lexidays/michess/hardware/antenna-design/coil-drum/coil-drum.FCStd

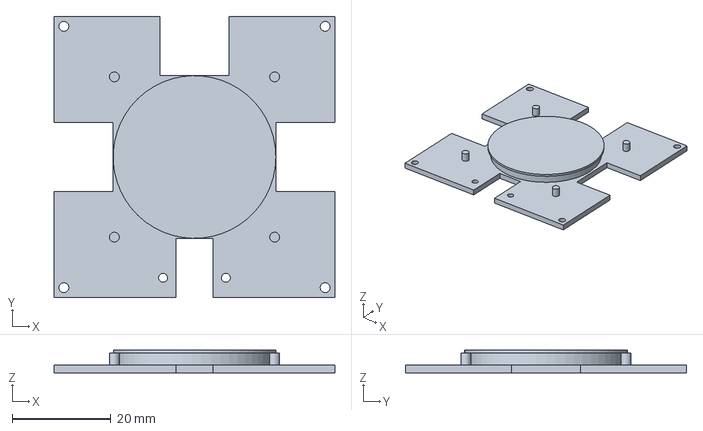
[picture p1: CAD file, 2026-11-11]
hardware/antenna-design/coil-drum/coil-drum.FCStd
57.0 x 57.0 x 4.60 mm
