lexidays/michess/hardware/antenna-design/coil-drum/coil-drum-Body.stl

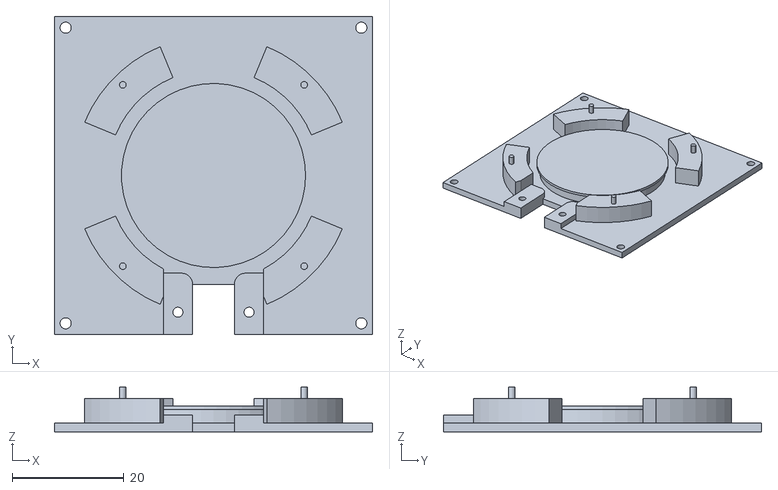
[picture p2: CAD file, 2026-11-04]
hardware/antenna-design/coil-drum/coil-drum-Body.stl
57.0 x 57.0 x 8.00
