lexidays/michess/(list of files, cad)

Other CAD files:
hardware/frame/frame.FCStd
