lexidays/michess/hardware/pcb/coil-connector-board/coil-connector-board.kicad_pcb

## KiCad design hardware/pcb/coil-connector-board/coil-connector-board.kicad_pcb (2026-11-11)

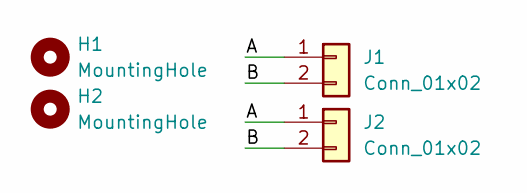
[picture p3: schematic coil-connector-board.kicad_sch]

Parts:
H1, H2: MountingHole; MountingHole_3.2mm_M3
J1: Conn_01x02; PinHeader_1x02_P2.54mm_Vertical
J2: Conn_01x02; JST_PH_S2B-PH-K_1x02_P2.00mm_Horizontal

Connections:
/A: J1.1, J2.1
/B: J1.2, J2.2

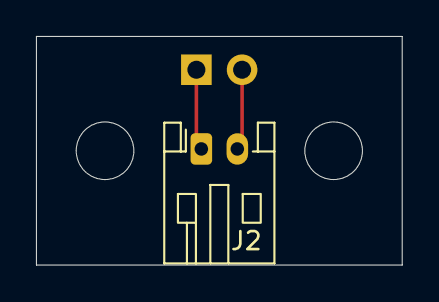
[picture p4: board coil-connector-board.kicad_pcb from above]

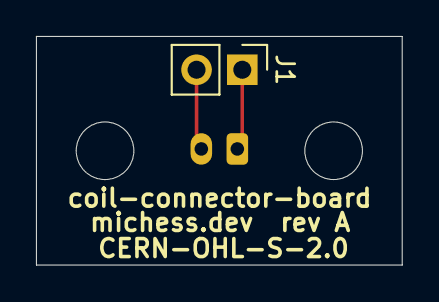
[picture p5: board coil-connector-board.kicad_pcb from below]

Board: 2 copper layers, 20.3 x 12.7 mm, 4 parts (3 on the bottom side), 2 nets.
