lexidays/michess/hardware/pcb/mux-board/mux-board.kicad_pcb

## KiCad design hardware/pcb/mux-board/mux-board.kicad_pcb (2026-11-11)

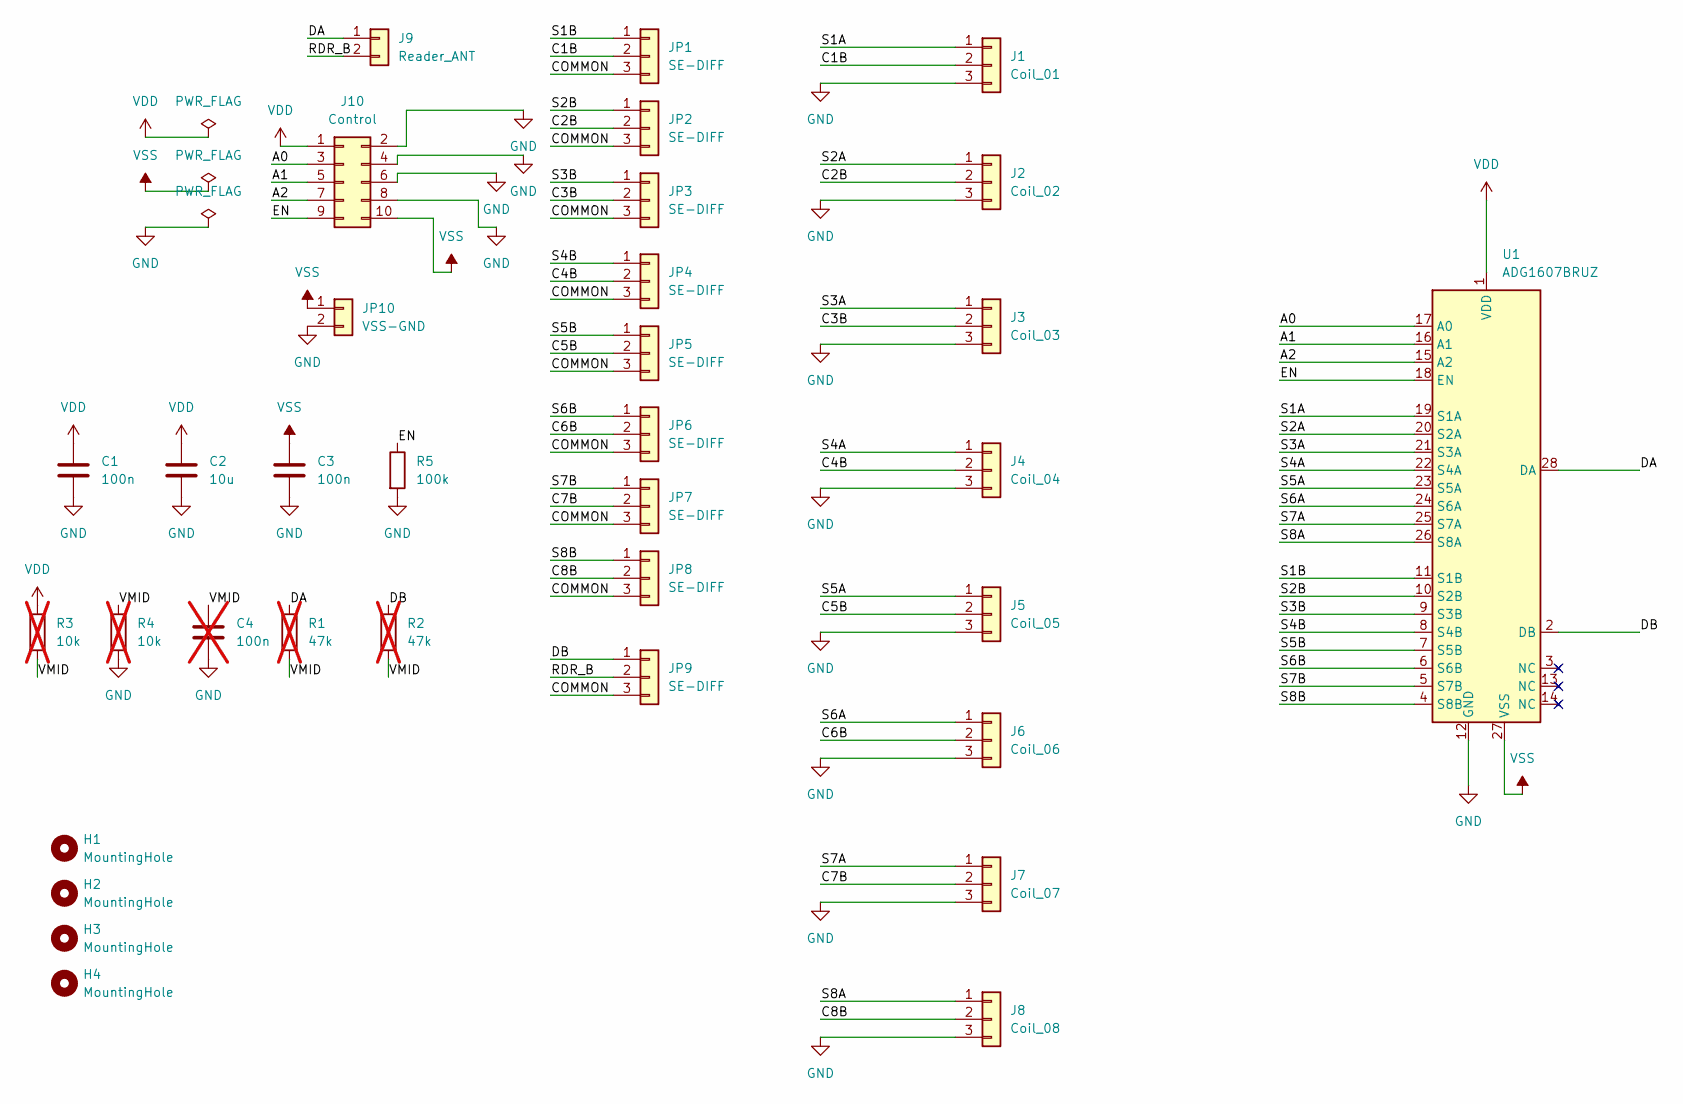
[picture p6: schematic mux-board.kicad_sch, michess mux board]

Parts:
C1, C3: 100n; C_0805_2012Metric_Pad1.18x1.45mm_HandSolder
C2: 10u; C_0805_2012Metric_Pad1.18x1.45mm_HandSolder
C4: 100n; C_0805_2012Metric_Pad1.18x1.45mm_HandSolder; not fitted
H1, H2, H3, H4: MountingHole; MountingHole_3.2mm_M3
J1: Coil_01; JST_PH_S3B-PH-K_1x03_P2.00mm_Horizontal
J2: Coil_02; JST_PH_S3B-PH-K_1x03_P2.00mm_Horizontal
J3: Coil_03; JST_PH_S3B-PH-K_1x03_P2.00mm_Horizontal
J4: Coil_04; JST_PH_S3B-PH-K_1x03_P2.00mm_Horizontal
J5: Coil_05; JST_PH_S3B-PH-K_1x03_P2.00mm_Horizontal
J6: Coil_06; JST_PH_S3B-PH-K_1x03_P2.00mm_Horizontal
J7: Coil_07; JST_PH_S3B-PH-K_1x03_P2.00mm_Horizontal
J8: Coil_08; JST_PH_S3B-PH-K_1x03_P2.00mm_Horizontal
J9: Reader_ANT; PinHeader_1x02_P2.54mm_Vertical
J10: Control; IDC-Header_2x05_P2.54mm_Horizontal
JP1, JP2, JP3, JP4, JP5, JP6, JP7, JP8, JP9: SE-DIFF; PinHeader_1x03_P2.54mm_Vertical
JP10: VSS-GND; PinHeader_1x02_P2.54mm_Vertical
R1, R2: 47k; R_Axial_DIN0309_L9.0mm_D3.2mm_P12.70mm_Horizontal; not fitted
R3, R4: 10k; R_Axial_DIN0309_L9.0mm_D3.2mm_P12.70mm_Horizontal; not fitted
R5: 100k; R_Axial_DIN0309_L9.0mm_D3.2mm_P12.70mm_Horizontal
U1: ADG1607BRUZ; TSSOP-28_4.4x9.7mm_P0.65mm

Connections:
/A0: J10.3, U1.17 (A0)
/A1: J10.5, U1.16 (A1)
/A2: J10.7, U1.15 (A2)
/C1B: J1.2, JP1.2
/C2B: J2.2, JP2.2
/C3B: J3.2, JP3.2
/C4B: J4.2, JP4.2
/C5B: J5.2, JP5.2
/C6B: J6.2, JP6.2
/C7B: J7.2, JP7.2
/C8B: J8.2, JP8.2
/COMMON: JP1.3, JP2.3, JP3.3, JP4.3, JP5.3, JP6.3, JP7.3, JP8.3, JP9.3
/DA: J9.1, R1.1, U1.28 (DA)
/DB: JP9.1, R2.1, U1.2 (DB)
/EN: J10.9, R5.1, U1.18 (EN)
/RDR_B: J9.2, JP9.2
/S1A: J1.1, U1.19 (S1A)
/S1B: JP1.1, U1.11 (S1B)
/S2A: J2.1, U1.20 (S2A)
/S2B: JP2.1, U1.10 (S2B)
/S3A: J3.1, U1.21 (S3A)
/S3B: JP3.1, U1.9 (S3B)
/S4A: J4.1, U1.22 (S4A)
/S4B: JP4.1, U1.8 (S4B)
/S5A: J5.1, U1.23 (S5A)
/S5B: JP5.1, U1.7 (S5B)
/S6A: J6.1, U1.24 (S6A)
/S6B: JP6.1, U1.6 (S6B)
/S7A: J7.1, U1.25 (S7A)
/S7B: JP7.1, U1.5 (S7B)
/S8A: J8.1, U1.26 (S8A)
/S8B: JP8.1, U1.4 (S8B)
/VMID: C4.1, R1.2, R2.2, R3.2, R4.1
GND: C1.2, C2.2, C3.2, C4.2, J1.3, J2.3, J3.3, J4.3, J5.3, J6.3, J7.3, J8.3, J10.2, J10.4, J10.6, J10.8, JP10.2, R4.2, R5.2, U1.12 (GND)
VDD: C1.1, C2.1, J10.1, R3.1, U1.1 (VDD)
VSS: C3.1, J10.10, JP10.1, U1.27 (VSS)

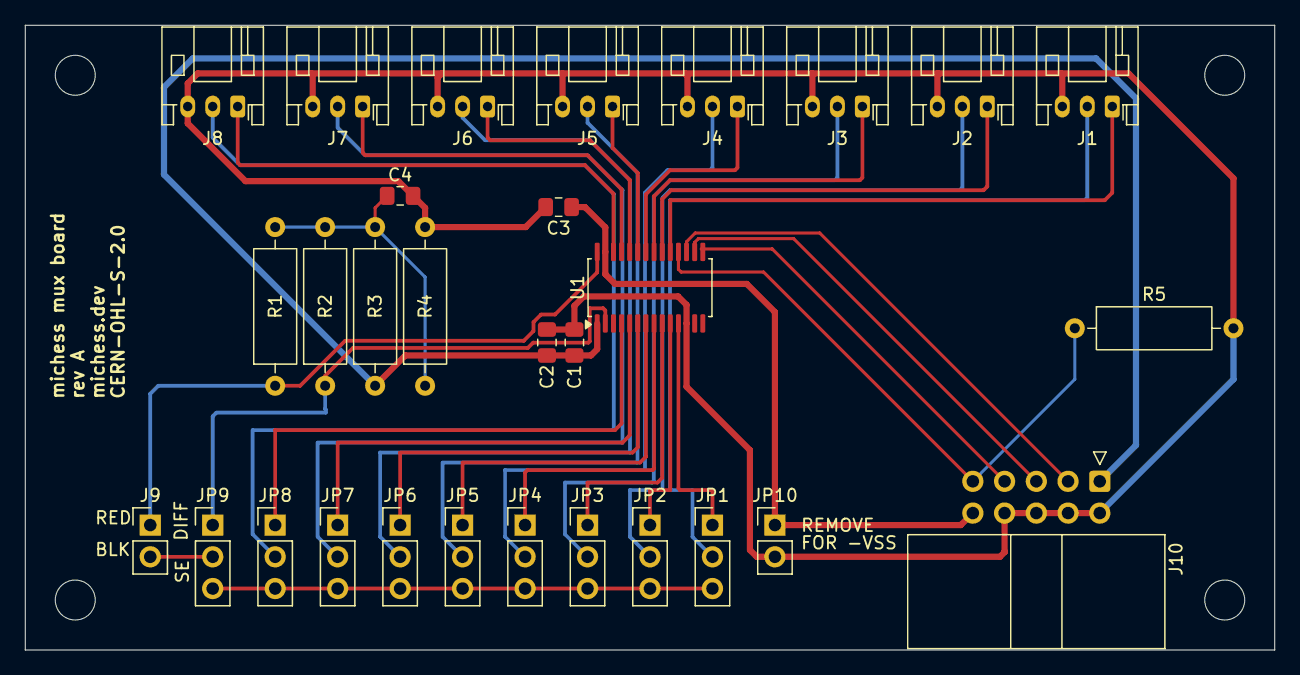
[picture p7: board mux-board.kicad_pcb from above]

Board: 2 copper layers, 100.0 x 50.0 mm, 34 parts (0 on the bottom side), 36 nets.
