lexidays/michess/(commit log)

2026-11-04 Prototype bring-up: reader, coils and mux switching (#20)
    First stage of the 4-square prototype: the reader working on a Raspberry Pi, hand-wound coils on printed tiles reading tags, and the multiplexer switching between coils.
    Closes #1. Part of #3.
    ## Harnesses (`development/`)
    - **`st25r-reader-tester/`**: Elechouse ST25R3916B MINI on a Pi 4 over SPI, using ST's RFAL driver (STSW-ST25R013, not committed; build steps in the README). IRQ moved to GPIO25. Reads NTAG213 tags, with a ~31 mm baseline read distance on the stock antenna.
    - **`mux-switch-tester/`**: drives the ADG1607 8:1 multiplexer from the Pi. Switching verified on all 8 channels (9.2–9.5 Ω on-resistance at 3.3 V). Also h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
    [coil-drum-Body.stl, coil-drum.FCStd, frame.FCStd, mux_results_20261029_1806.csv]
2026-11-11 Feature/12 mux board pcb (#24)
    * Added KiCad symbol library for ADG1607B
    * Mux board schematic: chip and coil sockets
    * Add KiCad history folder to .gitignore
    * Mux board: flatten project folder, relative library path, fix DB label
    * Corrections to mux board
    * Added jumpers
    * Corrections to pin header details
    * Added remaining jumpers/connectors
    * corrections
    * Footprint corrections
    * Resistors and capacitors
    * Power and tidy up
    * Started board layout
    * Initial placement
    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
    [mux-board.kicad_pcb, mux-board.kicad_sch]
2026-11-11 Feature/23 coil connector board pcb (#25)
    * 1st Draft
    * gitignore update
    * Silkscreen
    * Updated holes on schemaitc
    * Update export options
    [coil-connector-board.kicad_pcb, coil-connector-board.kicad_sch]
2026-11-11 Draft 4 of the coil drum tile
    [coil-drum.FCStd]
