lexidays/michess/(notices)

Notices in the files:
hardware/pcb/mux-board/mux-board.kicad_sch:
Licence: CERN-OHL-S v2
hardware/pcb/mux-board/mux-board.kicad_pcb:
CERN-OHL-S-2.0
